fnmax1/MiniArcadePCB/MiniArcade_Documentation/Bilder/Oszi_powersupply.jpg

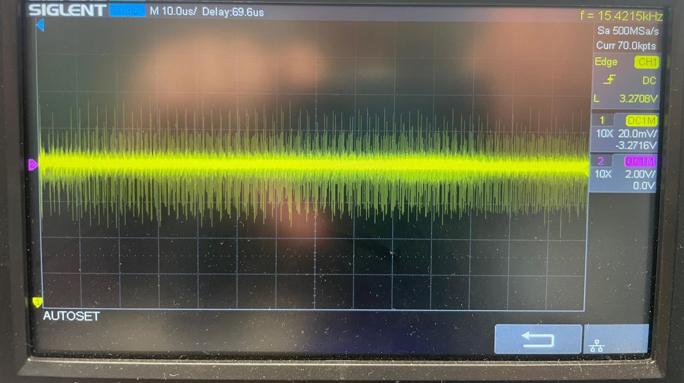
MiniArcade_Documentation/Bilder/Oszi_powersupply.jpg
