fnmax1/MiniArcadePCB/MiniArcade_Documentation/Bilder/Verbindungssystem.png

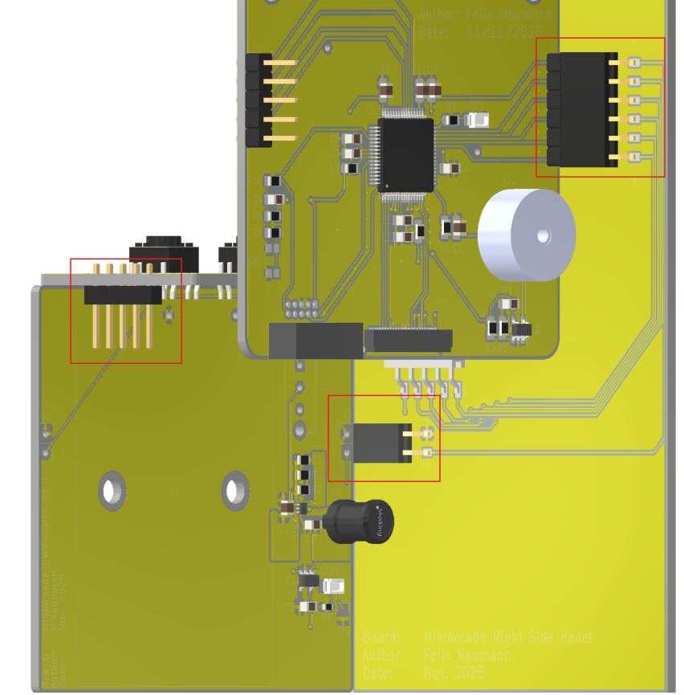
MiniArcade_Documentation/Bilder/Verbindungssystem.png
