fnmax1/MiniArcadePCB/README.md

# MiniArcade
This repository provides a complete kit for a handheld console
in the form of an arcade machine.
