fnmax1/MiniArcadePCB/MiniArcade_Documentation/Bilder/assynchroner Callback.png

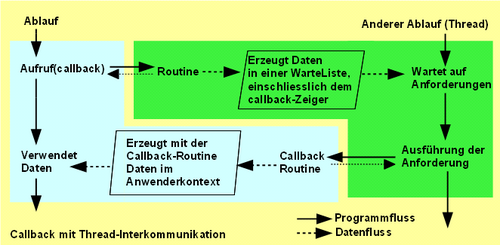
MiniArcade_Documentation/Bilder/assynchroner Callback.png
