fnmax1/MiniArcadePCB/MiniArcade_Documentation/Excel/BOM.xlsx

Funktion | Hersteller Bez. | Kosten in € | Anzahl |  | Website
Main Board
J-Tag Header | 62701021721 | 1.56 | 1 |  | https://www.mouser.de/ProductDetail/Wurth-Elektronik/62701021721?qs=1Kr7Jg1SGW%2FQWdVcBDZJJw%3D%3D
Mikrokonroller | SAMD21J18A-A
User LED | AA3021LZGSK | 0.46 | 1 |  | https://www.mouser.de/ProductDetail/Kingbright/AA3021LZGSK?qs=Oo40KB9lBTmpa6y%2FkjbgOw%3D%3D
Ferrit Bead | 742792022 | 0.2 | 1 |  | https://www.mouser.de/ProductDetail/Wurth-Elektronik/742792022?qs=5twSNpOB8IBksnQcn3fDWA%3D%3D
Piezo Buzzer | CPT-1207-3TH | 0.43 | 1 |  | https://www.mouser.de/ProductDetail/Same-Sky/CPT-1207-3TH?qs=yc9RBI4tIAKnzAUaZUSj3A%3D%3D
OpAmp | LM321LVIDBVR | 0.11 | 1 |  | https://www.mouser.de/ProductDetail/Texas-Instruments/LM321LVIDBVR?qs=qSfuJ%252Bfl%2Fd66sZ569ResAQ%3D%3D
LCD | ER-TFT1.44-1 | 2.42 | 1 | ??? | https://www.buydisplay.com/1-44-inch-tft-touch-screen-serial-spi-128x128-lcd-display-module-st7735
FPC-Connector | F3311A7H121026E200 | 0.34 | 1 |  | https://www.mouser.de/ProductDetail/Amphenol-Aorora/F3311A7H121026E200?qs=DPoM0jnrROWA%252B19vFqAjpg%3D%3D
Power Supply
Buck Converter | AP61100Z6-7 | 0.17 | 1 |  | https://www.mouser.de/ProductDetail/Diodes-Incorporated/AP61100Z6-7
Power LED | AA3021LZGSK | 0.46 | 1 |  | https://www.mouser.de/ProductDetail/Kingbright/AA3021LZGSK?qs=Oo40KB9lBTmpa6y%2FkjbgOw%3D%3D
LDO | MIC94310-SYM5-TR | 0.27 | 1 |  | https://www.mouser.de/ProductDetail/Microchip-Technology/MIC94310-SYM5-TR
Power-Switch | SLW-12689-4A-N-D | 0.29 | 1 |  | https://www.mouser.de/ProductDetail/Same-Sky/SLW-12689-4A-N-D?qs=IKkN%2F947nfDDpe%2FKbSKjtQ%3D%3D
Induktivität 2,2 uH | 7447462022 (https://www.we-online.com/de/components/products/WE-TI) | 0.82 | 1 |  | https://www.mouser.de/ProductDetail/Wurth-Elektronik/7447462022?qs=E%2F%2FhvbtCqpMsMx%2FJLvSyVw%3D%3D
Induktivität 3,3 uH | 7447462033 | 0.82 | 1 |  | https://www.mouser.de/ProductDetail/Wurth-Elektronik/7447462033?qs=E%2F%2FhvbtCqpPfgoKy1f3Gmg%3D%3D
Induktivität 4,7 uH | 7447462047 (https://www.we-online.com/de/components/products/WE-TI) | 0.82 | 1 |  | https://www.mouser.de/ProductDetail/Wurth-Elektronik/7447462047?qs=E%2F%2FhvbtCqpMqhMG1oun6Ug%3D%3D
Batterie Holder | 2479 | 1.26 | 1 |  | https://www.mouser.de/ProductDetail/Keystone-Electronics/2479?qs=Q3RoVmURDomBPD85HfXZoA%3D%3D
Controller
Joystick | 10*10*9-6P WX | 0.37 | 1 |  | https://www.lcsc.com/product-detail/C2858290.html
Left Side Panel
PinHeader_1x2_female_90° | M20-7910242R | 0.61 | 1 |  | https://www.mouser.de/ProductDetail/Harwin/M20-7910242R?qs=k41KVqW3ympOgmj181bijA%3D%3D
PinHeader_1x5_female_90° | M20-7910542R | 0.91 | 1 |  | https://www.mouser.de/ProductDetail/Harwin/M20-7910542R?qs=k41KVqW3ymo1Rw%252BkrmwYbQ%3D%3D
PinHeader_1x6_female_90° | M20-7910642R | 1.09 | 1 |  | https://www.mouser.de/ProductDetail/Harwin/M20-7910642R?qs=k41KVqW3ymovSPRowkWy%2Fg%3D%3D
Right Side Panel
PinHeader_1x2_female_90° | M20-7910242R | 0.61 | 1 |  | https://www.mouser.de/ProductDetail/Harwin/M20-7910242R?qs=k41KVqW3ympOgmj181bijA%3D%3D
PinHeader_1x5_female_90° | M20-7910542R | 0.91 | 2 |  | https://www.mouser.de/ProductDetail/Harwin/M20-7910542R?qs=k41KVqW3ymo1Rw%252BkrmwYbQ%3D%3D
USB-C | USB4125-GF-A | 0.51 | 1 |  | https://www.mouser.de/ProductDetail/GCT/USB4125-GF-A?qs=KUoIvG%2F9IlaIQ4zBJ6gLeA%3D%3D
