fnmax1/MiniArcadePCB/CAD/MiniArcade_Right_Sidepanel.step

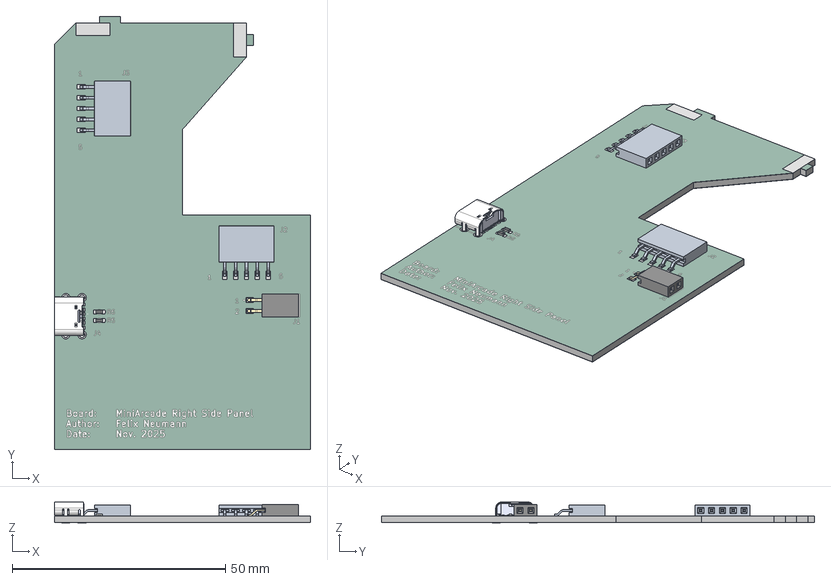
[picture p42: CAD file, 2025-11-26]
CAD/MiniArcade_Right_Sidepanel.step
60.0 x 101.5 x 4.87 mm
R_0603_1608Metric x 2
M20-7910242R
MiniArcade_Right_Sidepanel 1.3.1 x 2
USB4125-GF-A_PART1
MiniArcade_Right_Sidepanel_copper
MiniArcade_Right_Sidepanel_pad
MiniArcade_Right_Sidepanel_silkscreen
MiniArcade_Right_Sidepanel_soldermask x 2
MiniArcade_Right_Sidepanel_PCB
