fnmax1/MiniArcadePCB/CAD/MiniArcade_Left_Sidepanel.step

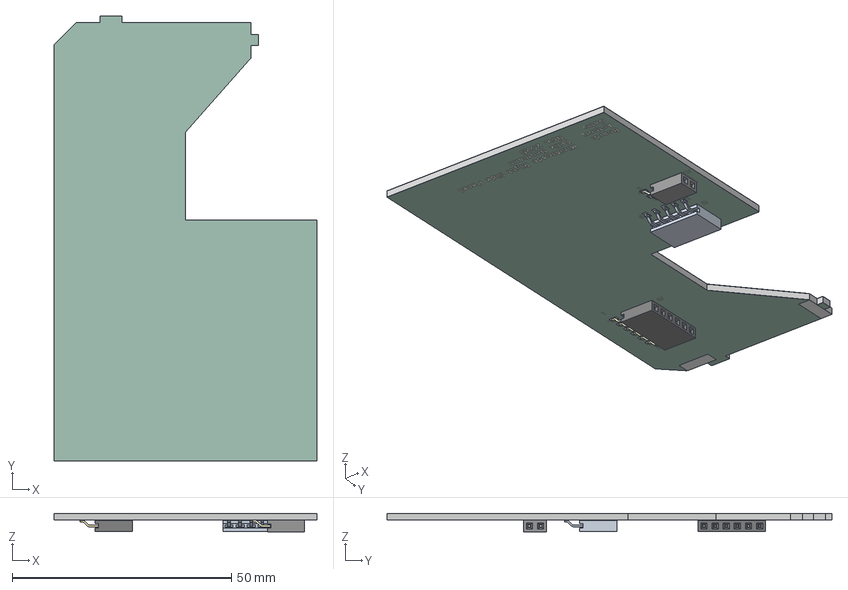
[picture p43: CAD file, 2025-11-26]
CAD/MiniArcade_Left_Sidepanel.step
60.0 x 101.5 x 4.23 mm
MiniArcade_Left_Sidepanel 1.1.1
M20-7910242R
M20-79106_MOULD
M20-79X_CONTACT x 6
MiniArcade_Left_Sidepanel_copper
MiniArcade_Left_Sidepanel_pad
MiniArcade_Left_Sidepanel_via
MiniArcade_Left_Sidepanel_silkscreen
MiniArcade_Left_Sidepanel_soldermask x 2
MiniArcade_Left_Sidepanel_PCB
