fnmax1/MiniArcadePCB/CAD/MiniArcade_Controller.step

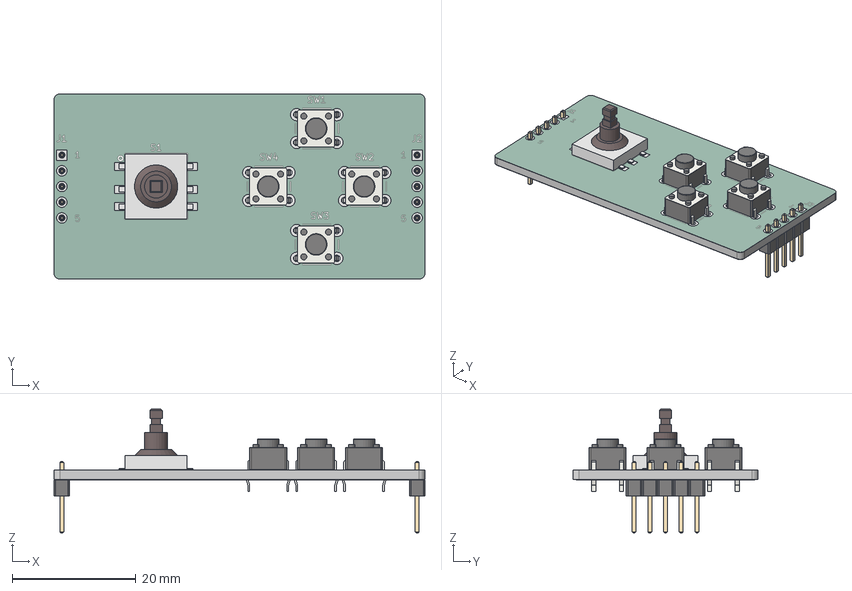
[picture p44: CAD file, 2025-11-26]
CAD/MiniArcade_Controller.step
60.0 x 30.0 x 20.0 mm
SW_PUSH_6mm_H5mm x 4
Joystick
PinHeader_1x05_P2.54mm_Vertical x 2
MiniArcade_Controller_copper
MiniArcade_Controller_pad
MiniArcade_Controller_via
MiniArcade_Controller_silkscreen x 2
MiniArcade_Controller_soldermask x 2
MiniArcade_Controller_PCB
