fnmax1/MiniArcadePCB/CAD/MiniArcade_Back_Cover.step

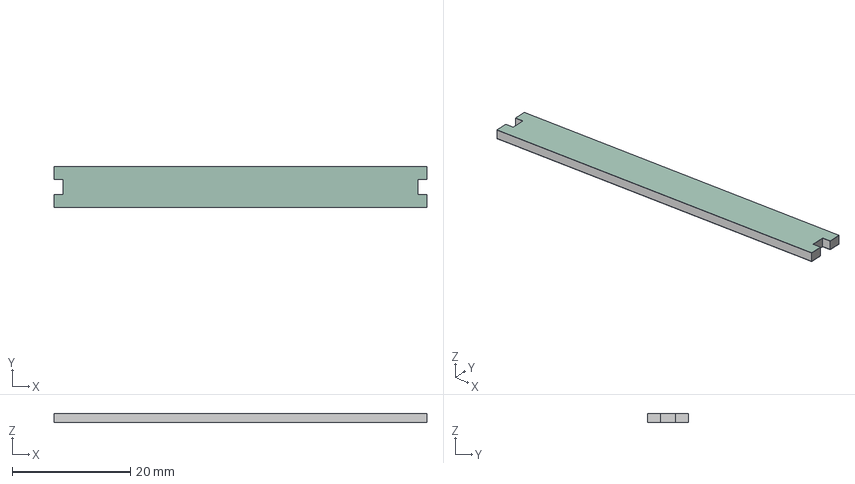
[picture p45: CAD file, 2025-11-25]
CAD/MiniArcade_Back_Cover.step
63.0 x 7.00 x 1.61 mm
MiniArcade_Back_Cover_pad
MiniArcade_Back_Cover_soldermask x 2
MiniArcade_Back_Cover_PCB
