fnmax1/MiniArcadePCB/CAD/MiniArcade_Top_Cover.step

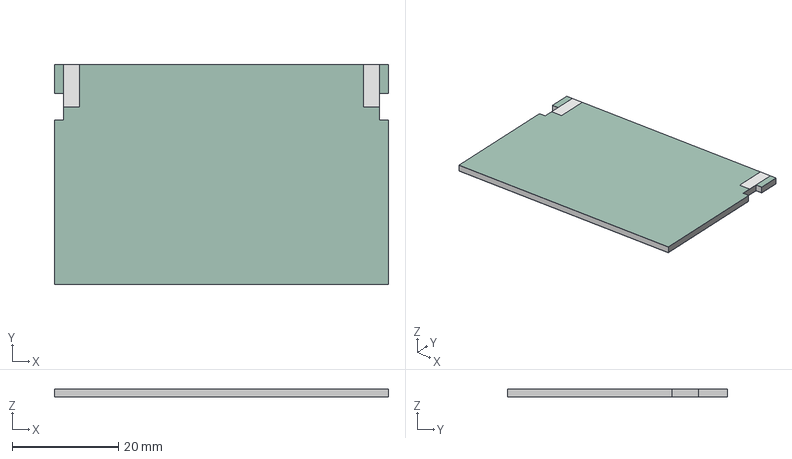
[picture p46: CAD file, 2025-11-25]
CAD/MiniArcade_Top_Cover.step
63.0 x 41.5 x 1.61 mm
MiniArcade_Top_Cover_pad
MiniArcade_Top_Cover_soldermask x 2
MiniArcade_Top_Cover_PCB
