fnmax1/MiniArcadePCB/CAD/MiniArcade_Panel.step

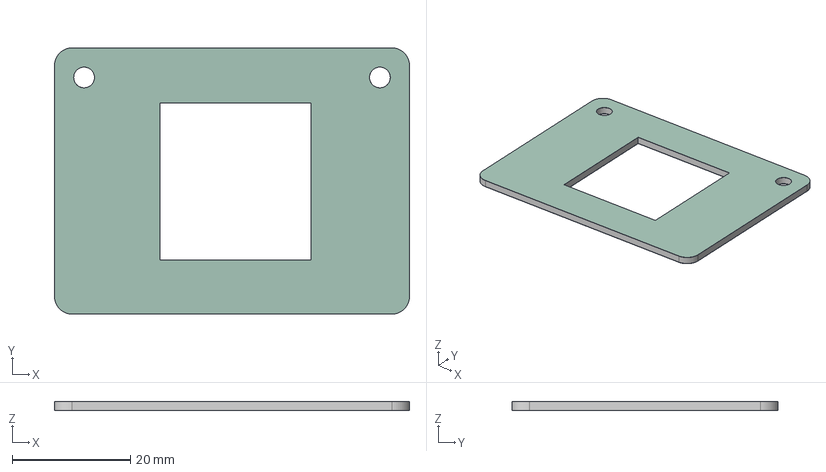
[picture p47: CAD file, 2025-11-21]
CAD/MiniArcade_Panel.step
60.0 x 45.0 x 1.61 mm
MiniArcade_Panel_copper
MiniArcade_Panel_soldermask x 2
MiniArcade_Panel_PCB
