fnmax1/MiniArcadePCB/CAD/MiniArcade_Front_Cover.step

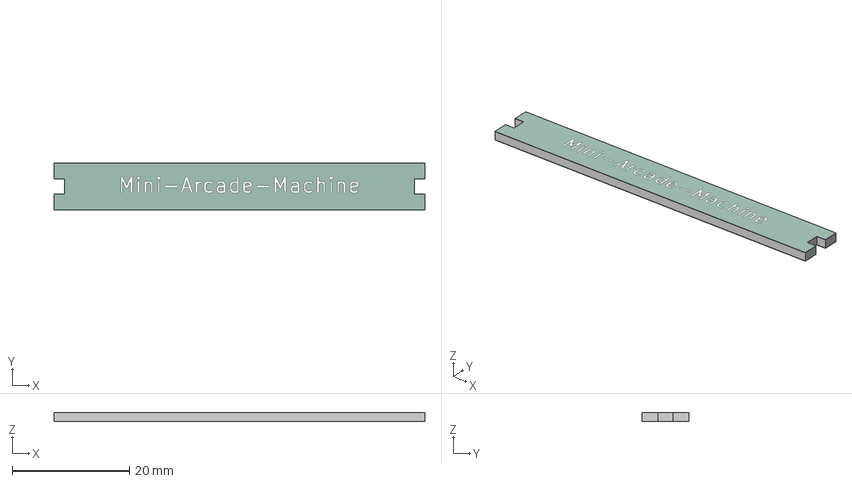
[picture p48: CAD file, 2025-11-21]
CAD/MiniArcade_Front_Cover.step
63.2 x 8.00 x 1.64 mm
MiniArcade_Front_Cover_pad
MiniArcade_Front_Cover_silkscreen
MiniArcade_Front_Cover_soldermask x 2
MiniArcade_Front_Cover_PCB
