fnmax1/MiniArcadePCB/CAD/Spacer_6mm.stp

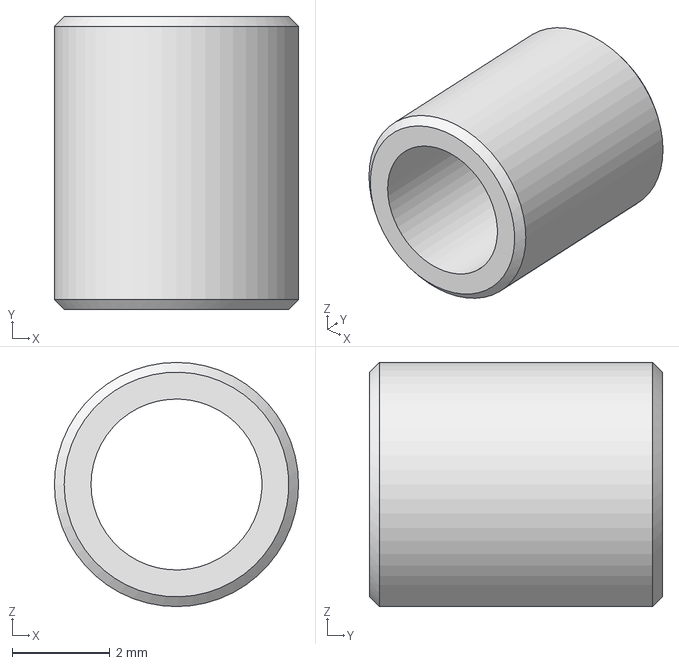
[picture p49: CAD file, 2025-11-21]
CAD/Spacer_6mm.stp
5.00 x 6.00 x 5.00 mm
