fnmax1/MiniArcadePCB/CAD/ERTFT144.stp

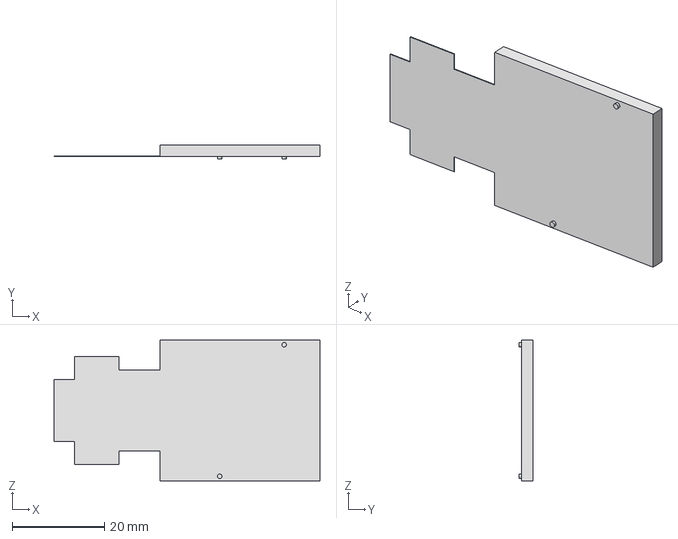
[picture p50: CAD file, 2025-11-19]
CAD/ERTFT144.stp
57.8 x 3.00 x 30.6 mm
