fnmax1/MiniArcadePCB/MiniArcade_PWR_Supply/MiniArcade_PWR_Supply/MiniArcade_PWR_Supply.kicad_pcb

## KiCad design MiniArcade_PWR_Supply/MiniArcade_PWR_Supply/MiniArcade_PWR_Supply.kicad_pcb (2025-12-08)

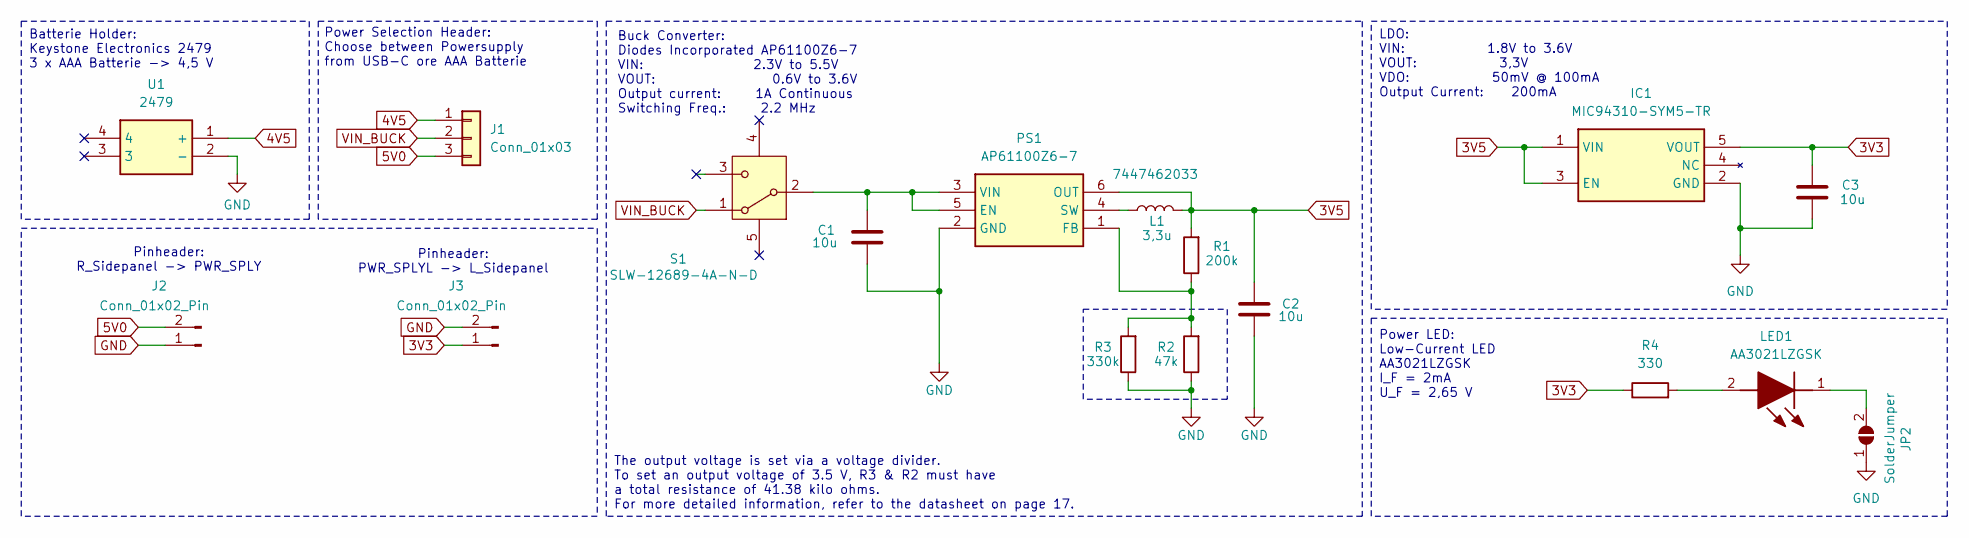
[picture p51: schematic MiniArcade_PWR_Supply.kicad_sch, MiniArcadePowerSupply]

Parts:
C1, C2, C3: 10u; C_0805_2012Metric_Pad1.18x1.45mm_HandSolder
IC1: MIC94310-SYM5-TR; SOT95P280X130-5N; Mouser Part Number 998-MIC94310-SYM5TR
J1: Conn_01x03; PinHeader_1x03_P1.00mm_Vertical
J2, J3: Conn_01x02_Pin; PinHeader_1x02_P2.54mm_Vertical
JP2: SolderJumper; SolderJumper-2_P1.3mm_Open_Pad1.0x1.5mm
L1: 3,3u; WE-TI_507589
LED1: AA3021LZGSK; LEDM3020X150N; Mouser Part Number 604-AA3021LZGSK
PS1: AP61100Z6-7; SOT50P162X60-6N; Mouser Part Number 621-AP61100Z6-7
R1: 200k; R_0805_2012Metric_Pad1.20x1.40mm_HandSolder
R2: 47k; R_0805_2012Metric_Pad1.20x1.40mm_HandSolder
R3: 330k; R_0805_2012Metric_Pad1.20x1.40mm_HandSolder
R4: 330; R_0603_1608Metric_Pad0.98x0.95mm_HandSolder
S1: SLW-12689-4A-N-D; SLW126894AND; Mouser Part Number 179-SLW126894AND
U1: 2479; Mouser Part Number 534-2479

Connections:
3V3: C3.1, IC1.5 (VOUT), J3.1, R4.1
3V5: C2.1, IC1.1 (VIN), IC1.3 (EN), L1.2, PS1.6 (OUT), R1.2
4V5: J1.1, U1.1 (+)
5V0: J1.3, J2.2
GND: C1.2, C2.2, C3.2, IC1.2 (GND), J2.1, J3.2, JP2.1 (A), PS1.2 (GND), R2.1, R3.1, U1.2 (-)
unnamed: JP2.2 (B), LED1.1 (K)
unnamed: LED1.2 (A), R4.2
unnamed: C1.1, PS1.3 (VIN), PS1.5 (EN), S1.2
unnamed: PS1.1 (FB), R1.1, R2.2, R3.2
unnamed: L1.1, PS1.4 (SW)
VIN_BUCK: J1.2, S1.1

Notes on the sheet:
Pinheader: R_Sidepanel -> PWR_SPLY
Batterie Holder: Keystone Electronics 2479 3 x AAA Batterie -> 4,5 V
Power Selection Header: Choose between Powersupply from USB-C ore AAA Batterie
Pinheader: PWR_SPLYL -> L_Sidepanel
The output voltage is set via a voltage divider. To set an output voltage of 3.5 V, R3 & R2 must have a total resistance of 41.38 kilo ohms. For more detailed information, refer to the datasheet on page 17.
Power LED: Low-Current LED AA3021LZGSK I_F = 2mA U_F = 2,65 V
Buck Converter: Diodes Incorporated AP61100Z6-7 VIN: 2.3V to 5.5V VOUT: 0.6V to 3.6V Output current: 1A Continuous Switching Freq.: 2.2 MHz
LDO: VIN: 1.8V to 3.6V VOUT: 3,3V VDO: 50mV @ 100mA Output Current: 200mA

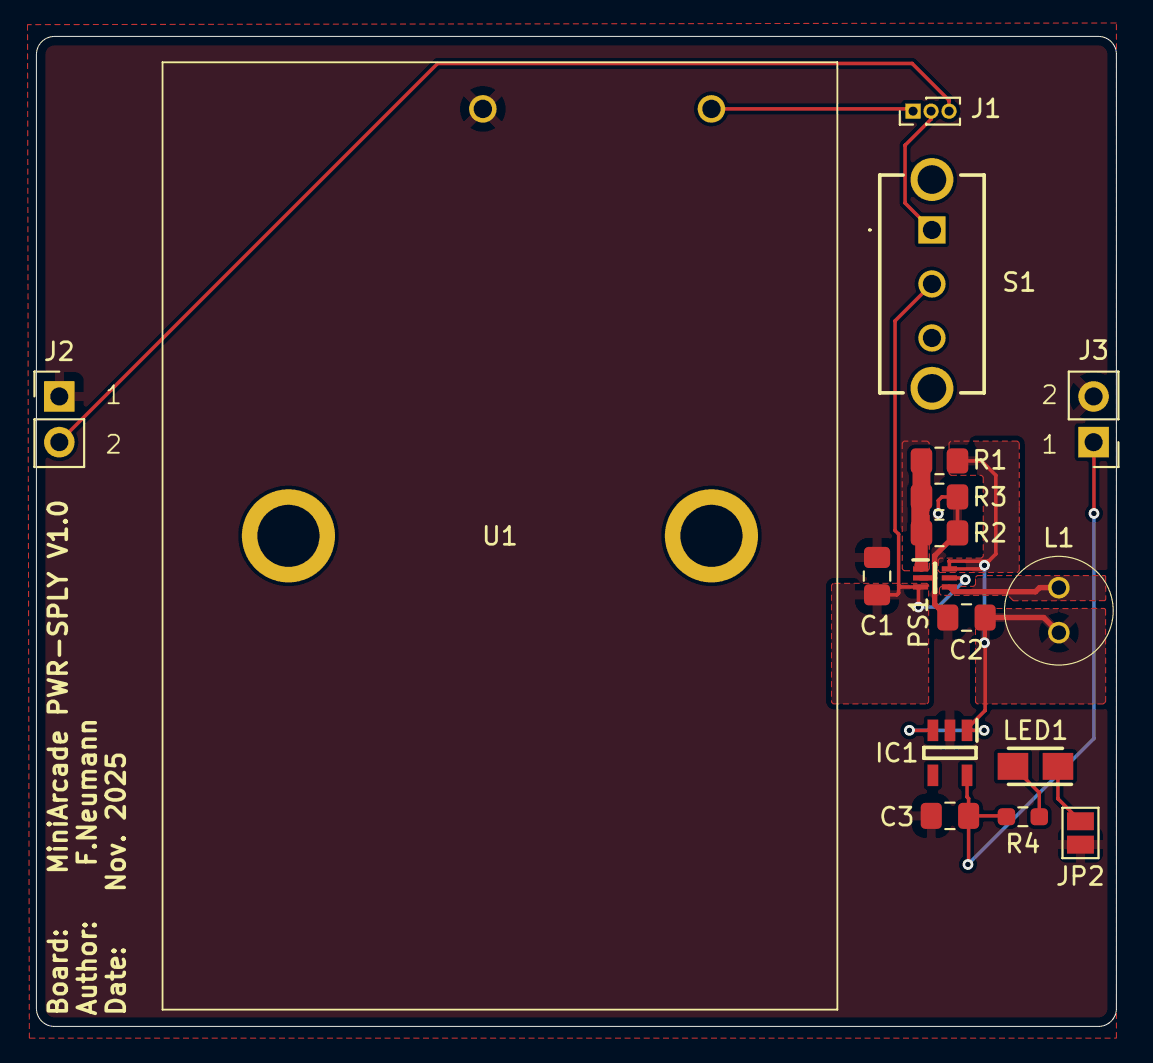
[picture p52: board MiniArcade_PWR_Supply.kicad_pcb from above]

Board: 2 copper layers, 60.0 x 55.0 mm, 17 parts (0 on the bottom side), 11 nets.
