fnmax1/MiniArcadePCB/MiniArcade_Controller/MiniArcade_Controller.kicad_pcb

## KiCad design MiniArcade_Controller/MiniArcade_Controller.kicad_pcb (2025-11-26)

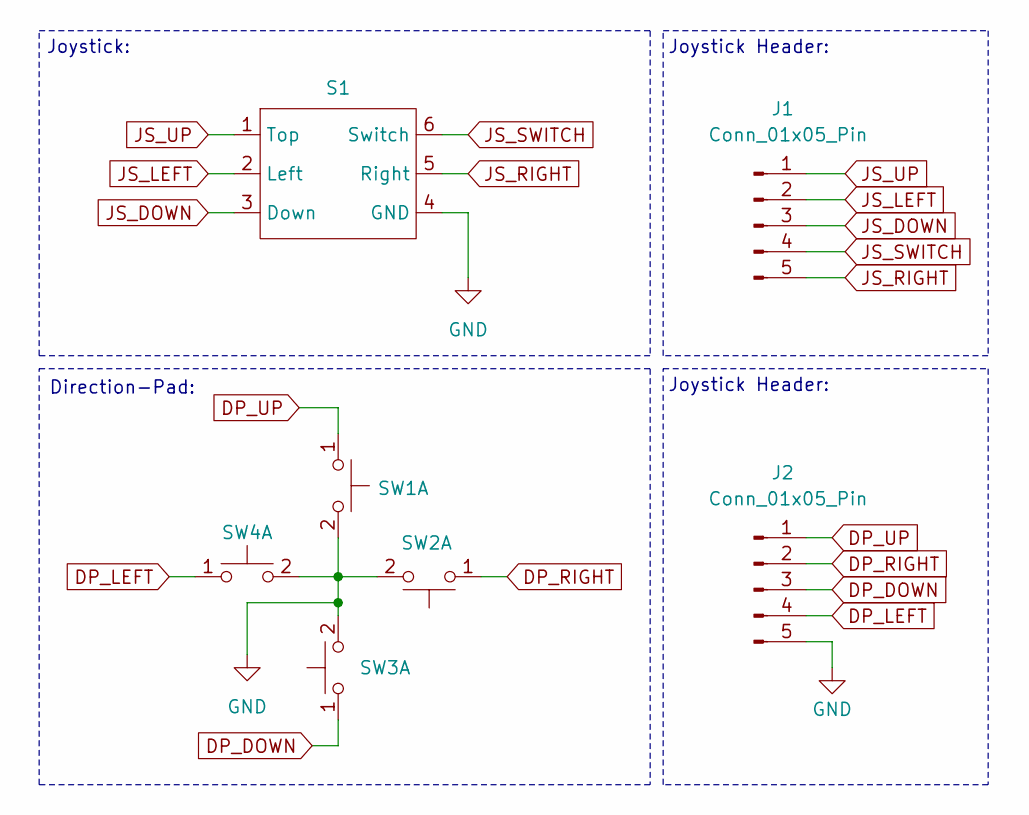
[picture p53: schematic MiniArcade_Controller.kicad_sch, MiniArcadeController]

Parts:
J1, J2: Conn_01x05_Pin; PinHeader_1x05_P2.54mm_Vertical
S1: Joystick
SW1, SW2, SW3, SW4: SW_Push_Dual_x2; SW_PUSH_6mm_H5mm

Connections:
DP_DOWN: J2.3, SW3.1 (C)
DP_LEFT: J2.4, SW4.1 (C)
DP_RIGHT: J2.2, SW2.1 (C)
DP_UP: J2.1, SW1.1 (C)
GND: J2.5, S1.4 (GND), SW1.2 (D), SW2.2 (D), SW3.2 (D), SW4.2 (D)
JS_DOWN: J1.3, S1.3 (Down)
JS_LEFT: J1.2, S1.2 (Left)
JS_RIGHT: J1.5, S1.5 (Right)
JS_SWITCH: J1.4, S1.6 (Switch)
JS_UP: J1.1, S1.1 (Top)

Notes on the sheet:
Joystick Header:
Direction-Pad:
Joystick:

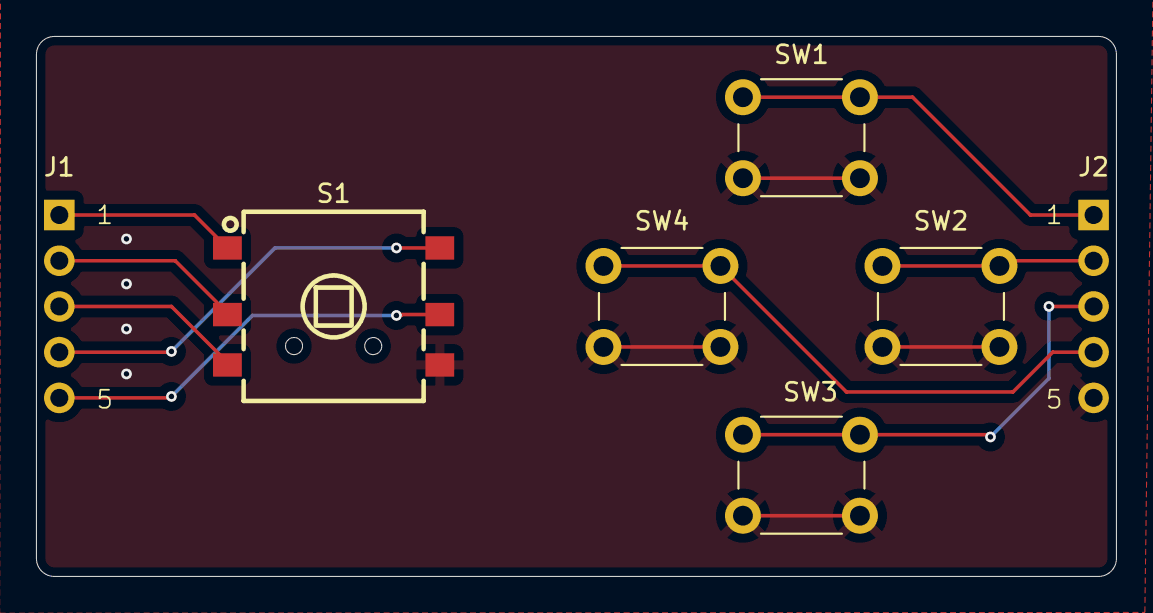
[picture p54: board MiniArcade_Controller.kicad_pcb from above]

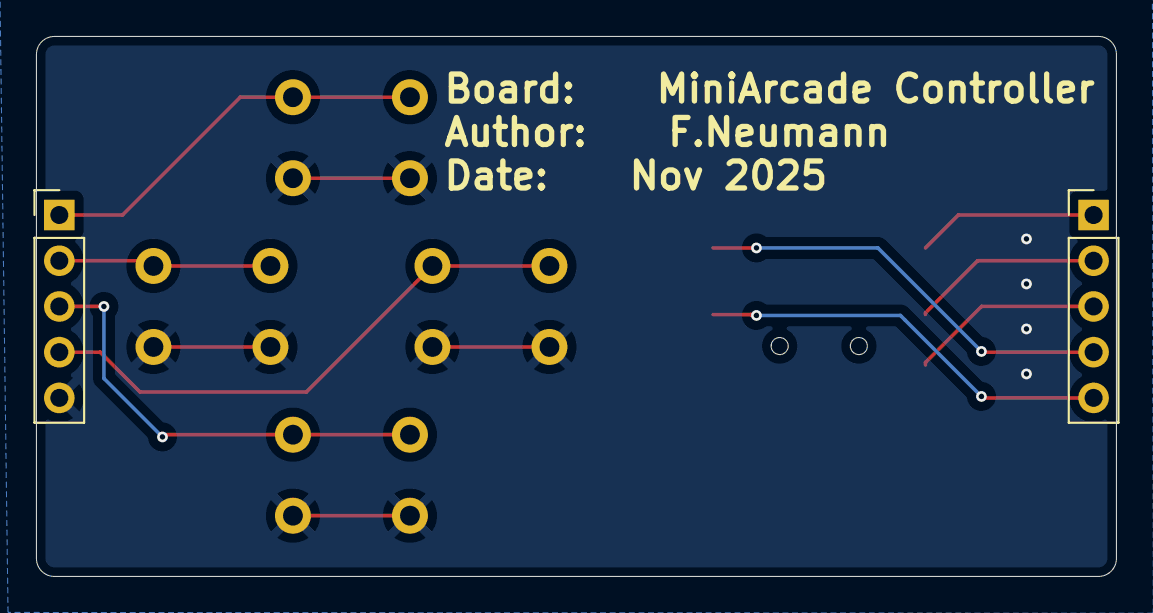
[picture p55: board MiniArcade_Controller.kicad_pcb from below]

Board: 2 copper layers, 60.0 x 30.0 mm, 7 parts (2 on the bottom side), 10 nets.
