fnmax1/MiniArcadePCB/MiniArcade_Right_Sidepanel/MiniArcade_Right_Sidepanel.kicad_pcb

## KiCad design MiniArcade_Right_Sidepanel/MiniArcade_Right_Sidepanel.kicad_pcb (2025-11-26)

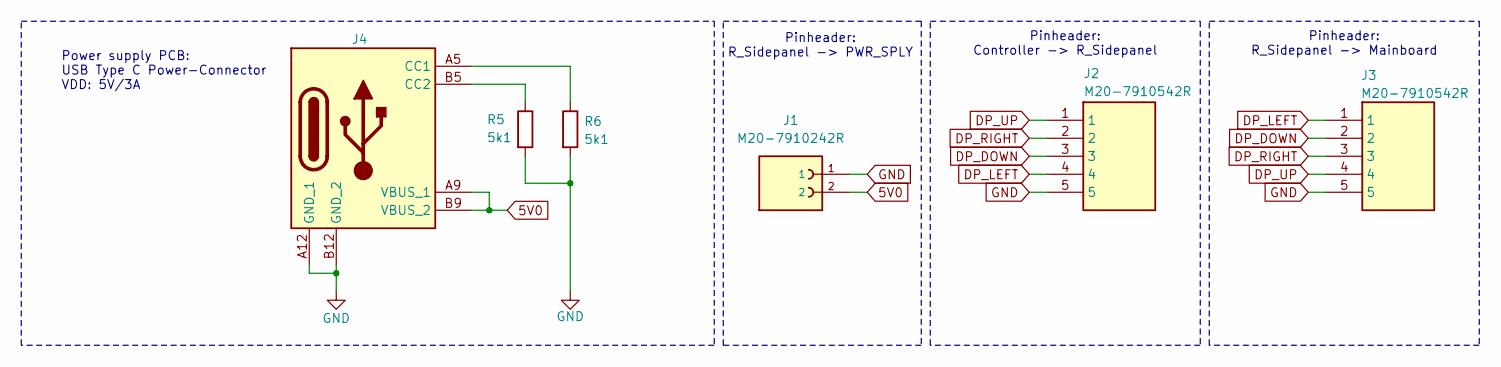
[picture p56: schematic MiniArcade_Right_Sidepanel.kicad_sch]

Parts:
J1: M20-7910242R; HARWIN_M20-7910242R; PARTREV 3
J2, J3: M20-7910542R; M207910542R; Mouser Part Number 855-M20-7910542R
J4: USB4125GFA
R5, R6: 5k1; R_0603_1608Metric_Pad0.98x0.95mm_HandSolder

Connections:
5V0: J1.2, J4.A9 (VBUS_1), J4.B9 (VBUS_2)
DP_DOWN: J2.3, J3.2
DP_LEFT: J2.4, J3.1
DP_RIGHT: J2.2, J3.3
DP_UP: J2.1, J3.4
GND: J1.1, J2.5, J3.5, J4.A12 (GND_1), J4.B12 (GND_2), R5.2, R6.2
unnamed: J4.A5 (CC1), R6.1
unnamed: J4.B5 (CC2), R5.1

Notes on the sheet:
Pinheader: R_Sidepanel -> Mainboard
Power supply PCB: USB Type C Power-Connector VDD: 5V/3A
Pinheader: Controller -> R_Sidepanel
Pinheader: R_Sidepanel -> PWR_SPLY

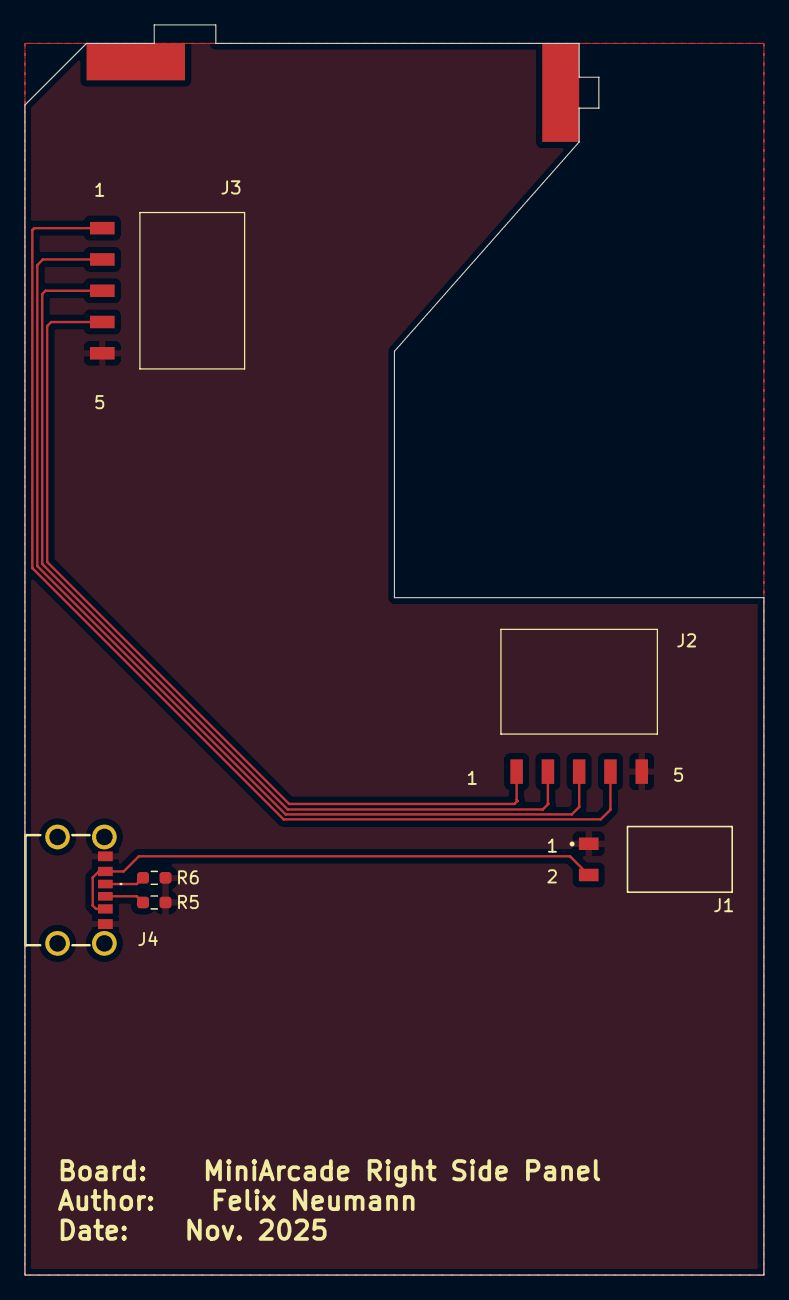
[picture p57: board MiniArcade_Right_Sidepanel.kicad_pcb from above]

Board: 2 copper layers, 60.0 x 101.5 mm, 6 parts (0 on the bottom side), 8 nets.
