fnmax1/MiniArcadePCB/MiniArcade_MainBoard/MiniArcade_MainBoard.kicad_pcb

## KiCad design MiniArcade_MainBoard/MiniArcade_MainBoard.kicad_pcb (2025-11-26)

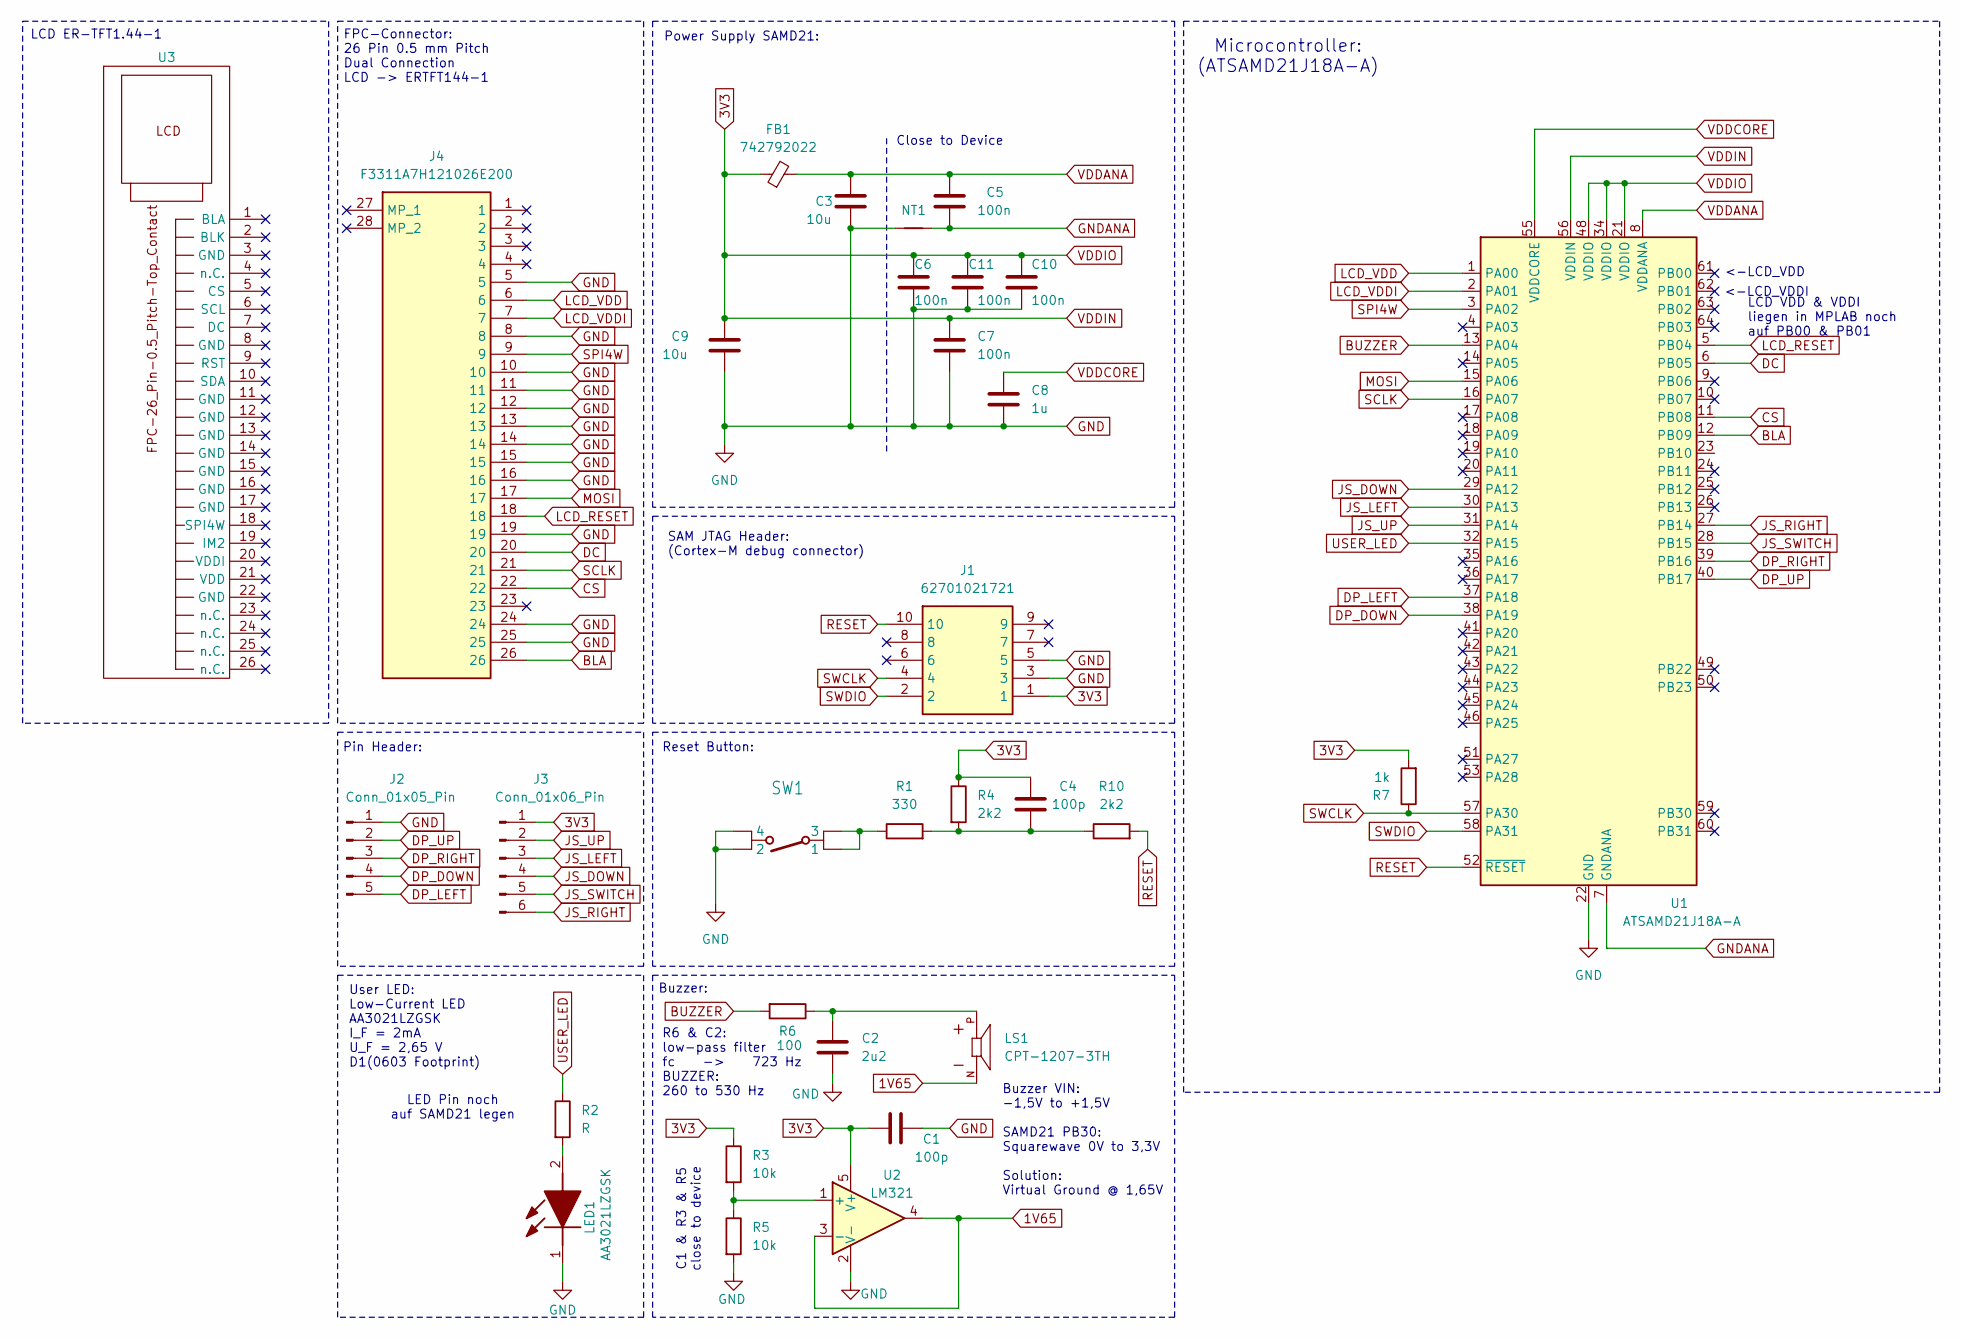
[picture p58: schematic MiniArcade_MainBoard.kicad_sch, MiniArcadeMainboard]

Parts:
C1, C4: 100p; C_0805_2012Metric_Pad1.18x1.45mm_HandSolder
C2: 2u2; C_0805_2012Metric_Pad1.18x1.45mm_HandSolder
C3, C9: 10u; C_0805_2012Metric_Pad1.18x1.45mm_HandSolder
C5, C6, C7, C10, C11: 100n; C_0805_2012Metric_Pad1.18x1.45mm_HandSolder
C8: 1u; C_0805_2012Metric_Pad1.18x1.45mm_HandSolder
FB1: 742792022; R_0805_2012Metric_Pad1.20x1.40mm_HandSolder; Mouser Part Number 710-742792022
J1: 62701021721; Manufacturer_Part_Number 62701021721
J2: Conn_01x05_Pin; PinHeader_1x05_P2.54mm_Vertical
J3: Conn_01x06_Pin; PinHeader_1x06_P2.54mm_Vertical
J4: F3311A7H121026E200; Mouser Part Number 649-311A7H121026E200
LED1: AA3021LZGSK; LEDM3020X150N; Mouser Part Number 604-AA3021LZGSK
LS1: CPT-1207-3TH; SPKR_CPT-1207-3TH; PARTREV 1.0
NT1: NetTie_2; NetTie-2_SMD_Pad0.5mm
R1: 330; R_0805_2012Metric_Pad1.20x1.40mm_HandSolder
R2: R; R_0805_2012Metric_Pad1.20x1.40mm_HandSolder
R3, R5: 10k; R_0805_2012Metric_Pad1.20x1.40mm_HandSolder
R4, R10: 2k2; R_0805_2012Metric_Pad1.20x1.40mm_HandSolder
R6: 100; R_0805_2012Metric_Pad1.20x1.40mm_HandSolder
R7: 1k; R_0805_2012Metric_Pad1.20x1.40mm_HandSolder
SW1: EVPAA
U1: ATSAMD21J18A-A; TQFP-64_10x10mm_P0.5mm
U2: LM321; SOT95P280X145-5N
U3: ERTFT144

Connections:
1V65: LS1.N, U2.3 (-), U2.4
3V3: C1.1, C4.1, C6.1, C7.1, C9.1, C10.1, C11.1, FB1.1, J1.1, J3.1, R3.1, R4.1, R7.2, U1.21 (VDDIO), U1.34 (VDDIO), U1.48 (VDDIO), U1.56 (VDDIN), U2.5 (V+)
BLA: J4.26, U1.12 (PB09)
BUZZER: R6.2, U1.13 (PA04)
CS: J4.22, U1.11 (PB08)
DC: J4.20, U1.6 (PB05)
DP_DOWN: J2.4, U1.38 (PA19)
DP_LEFT: J2.5, U1.37 (PA18)
DP_RIGHT: J2.3, U1.39 (PB16)
DP_UP: J2.2, U1.40 (PB17)
GND: C1.2, C2.1, C3.2, C6.2, C7.2, C8.2, C9.2, C10.2, C11.2, J1.3, J1.5, J2.1, J4.5, J4.8, J4.10, J4.11, J4.12, J4.13, J4.14, J4.15, J4.16, J4.19, J4.24, J4.25, LED1.1 (K), NT1.1, R5.2, SW1.2, SW1.4, U1.22 (GND), U1.33 (GND), U1.47 (GND), U1.54 (GND), U2.2 (V-)
GNDANA: C5.2, NT1.2, U1.7 (GNDANA)
JS_DOWN: J3.4, U1.29 (PA12)
JS_LEFT: J3.3, U1.30 (PA13)
JS_RIGHT: J3.6, U1.27 (PB14)
JS_SWITCH: J3.5, U1.28 (PB15)
JS_UP: J3.2, U1.31 (PA14)
LCD_RESET: J4.18, U1.5 (PB04)
LCD_VDD: J4.6, U1.1 (PA00)
LCD_VDDI: J4.7, U1.2 (PA01)
MOSI: J4.17, U1.15 (PA06)
unnamed: C2.2, LS1.P, R6.1
unnamed: C4.2, R1.2, R4.2, R10.1
unnamed: LED1.2 (A), R2.2
unnamed: R1.1, SW1.1, SW1.3
unnamed: R3.2, R5.1, U2.1 (+)
RESET: J1.10, R10.2, U1.52 (~RESET)
SCLK: J4.21, U1.16 (PA07)
SPI4W: J4.9, U1.3 (PA02)
SWCLK: J1.4, R7.1, U1.57 (PA30)
SWDIO: J1.2, U1.58 (PA31)
USER_LED: R2.1, U1.32 (PA15)
VDDANA: C3.1, C5.1, FB1.2, U1.8 (VDDANA)
VDDCORE: C8.1, U1.55 (VDDCORE)

Notes on the sheet:
Power Supply SAMD21:
LCD VDD & VDDI liegen in MPLAB noch auf PB00 & PB01
SAM JTAG Header: (Cortex-M debug connector)
Buzzer:
User LED: Low-Current LED AA3021LZGSK I_F = 2mA U_F = 2,65 V D1(0603 Footprint)
LCD ER-TFT1.44-1
LED Pin noch auf SAMD21 legen
Reset Button:
<-LCD_VDD
Microcontroller: (ATSAMD21J18A-A)
Pin Header:
R6 & C2: low-pass filter fc -> 723 Hz BUZZER: 260 to 530 Hz
FPC-Connector: 26 Pin 0.5 mm Pitch Dual Connection LCD -> ERTFT144-1
Close to Device
Buzzer VIN: -1,5V to +1,5V SAMD21 PB30: Squarewave 0V to 3,3V Solution: Virtual Ground @ 1,65V
<-LCD_VDDI
C1 & R3 & R5 close to device

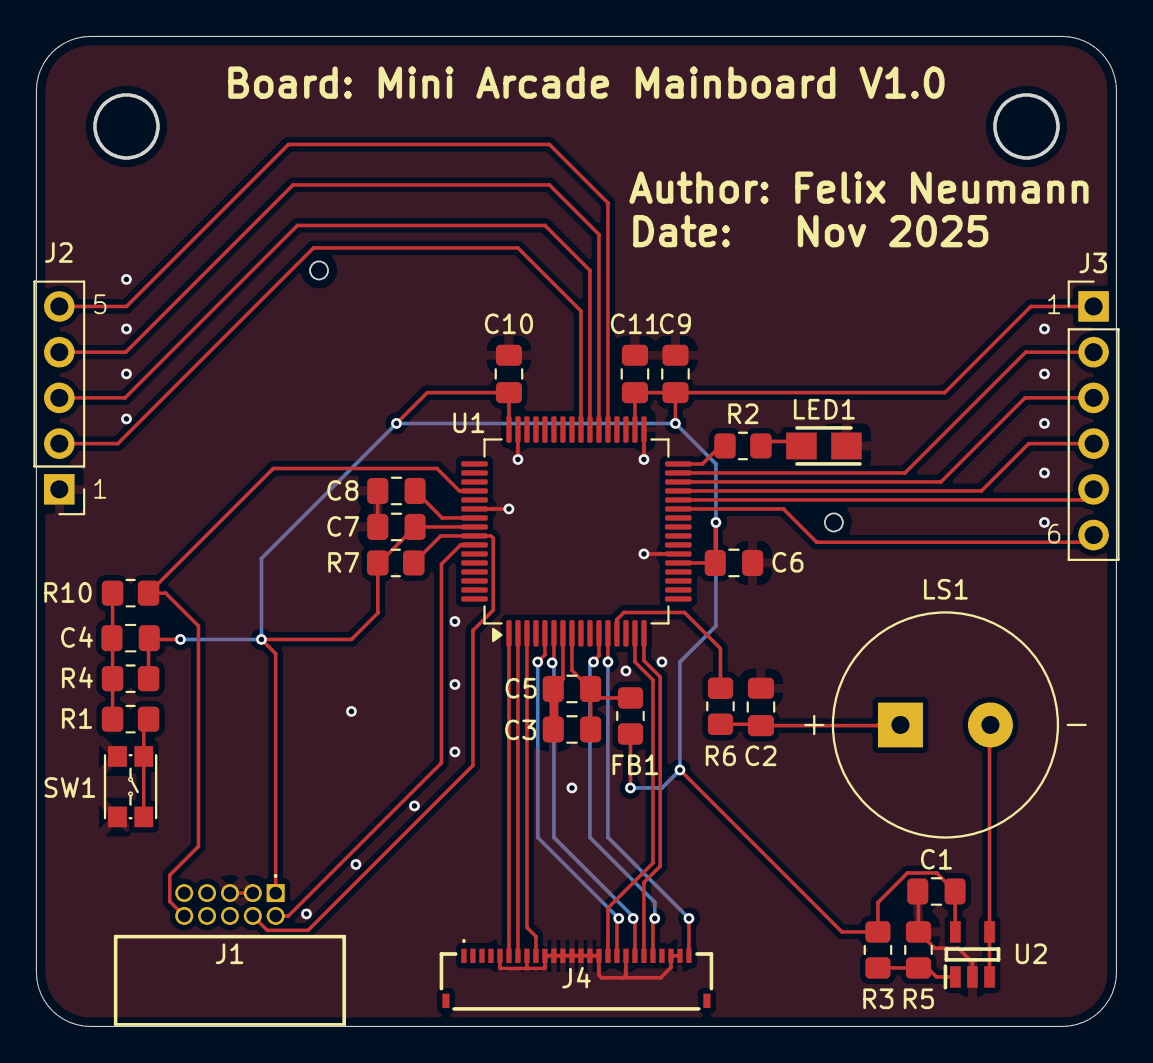
[picture p59: board MiniArcade_MainBoard.kicad_pcb from above]

Board: 2 copper layers, 60.0 x 55.0 mm, 31 parts (1 on the bottom side), 34 nets.
