fnmax1/MiniArcadePCB/MiniArcade_Left_Sidepanel/MiniArcade_Left_Sidepanel.kicad_pcb

## KiCad design MiniArcade_Left_Sidepanel/MiniArcade_Left_Sidepanel.kicad_pcb (2025-11-26)

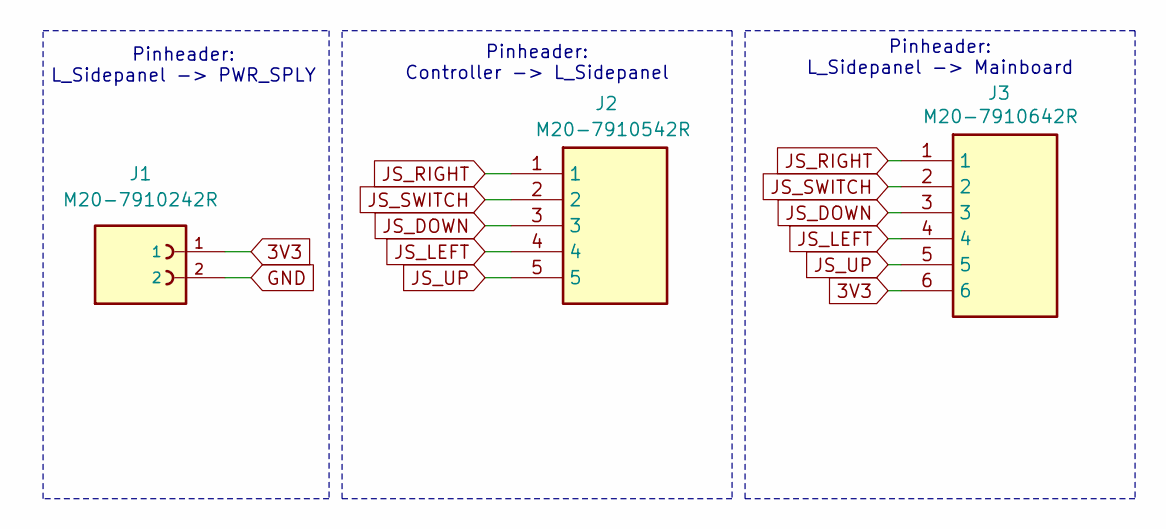
[picture p60: schematic MiniArcade_Left_Sidepanel.kicad_sch]

Parts:
J1: M20-7910242R; HARWIN_M20-7910242R; PARTREV 3
J2: M20-7910542R; M207910542R; Mouser Part Number 855-M20-7910542R
J3: M20-7910642R; M207910642R; Mouser Part Number 855-M20-7910642R

Connections:
3V3: J1.1, J3.6
GND: J1.2
JS_DOWN: J2.3, J3.3
JS_LEFT: J2.4, J3.4
JS_RIGHT: J2.1, J3.1
JS_SWITCH: J2.2, J3.2
JS_UP: J2.5, J3.5

Notes on the sheet:
Pinheader: Controller -> L_Sidepanel
Pinheader: L_Sidepanel -> PWR_SPLY
Pinheader: L_Sidepanel -> Mainboard

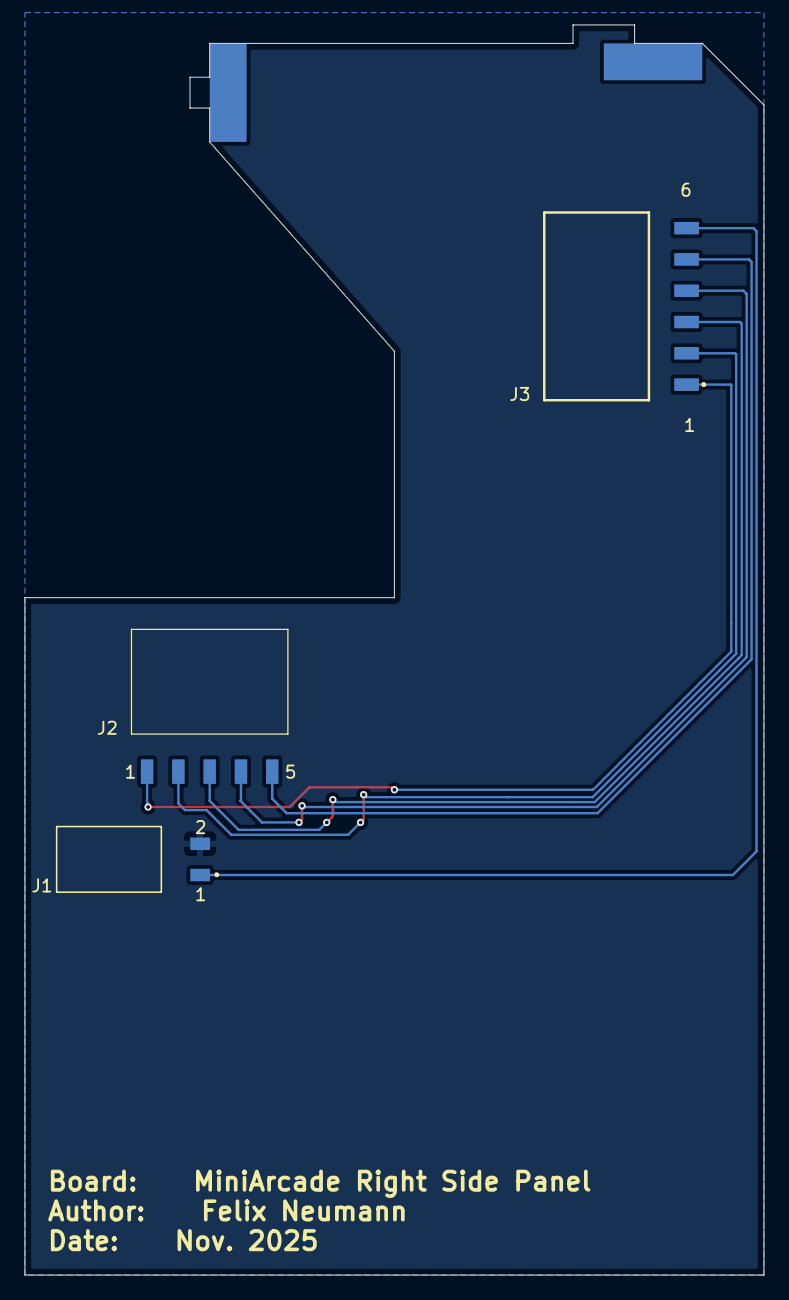
[picture p61: board MiniArcade_Left_Sidepanel.kicad_pcb from below]

Board: 2 copper layers, 60.0 x 101.5 mm, 3 parts (3 on the bottom side), 6 nets.
