fnmax1/MiniArcadePCB/(commit log)

2025-10-28 MiniArcadeController Initial Commit
    [MiniArcade_Controller.kicad_pcb, MiniArcade_Controller.kicad_sch]
2025-10-28 MiniArcadePowerSupply Initial Commit
    [MiniArcade_PWR_Supply.kicad_pcb, MiniArcade_PWR_Supply.kicad_sch]
2025-10-28 MiniArcade Mainboard Initial Commit
    [MiniArcade_MainBoard.kicad_pcb, MiniArcade_MainBoard.kicad_sch]
2025-10-29 added author and title to shemaitc
    [MiniArcade_Controller.kicad_sch]
2025-10-29 MiniArcade MainBoard & Power Supply initial commit
    [MiniArcade_MainBoard.csv, MiniArcade_MainBoard.kicad_pcb, MiniArcade_MainBoard.kicad_sch, MiniArcade_PWR_Supply.kicad_pcb, MiniArcade_PWR_Supply.kicad_sch]
2025-10-29 title and Author added
    [MiniArcade_MainBoard.kicad_sch, MiniArcade_PWR_Supply.kicad_sch]
2025-11-03 stand 03 11
    [BOM.xlsx, MiniArcade_Left_Sidepanel.kicad_pcb, MiniArcade_Left_Sidepanel.kicad_sch, MiniArcade_MainBoard.kicad_pcb, MiniArcade_MainBoard.kicad_sch, MiniArcade_PWR_Supply.kicad_pcb, MiniArcade_PWR_Supply.kicad_sch, Pin_Out_MiniArcade.xlsx]
2025-11-04 stand 04 11 2025
    [MiniArcade_MainBoard.kicad_pcb, MiniArcade_MainBoard.kicad_sch, Pin_Out_MiniArcade.xlsx]
2025-11-05 05 11 2025
    [BOM.xlsx, MiniArcade_Controller.kicad_pcb, MiniArcade_Controller.kicad_sch, MiniArcade_MainBoard.kicad_sch, MiniArcade_PWR_Supply.kicad_pcb, Pin_Out_MiniArcade.xlsx]
2025-11-10 10 11 2025
    [BOM.xlsx, MiniArcade_PWR_Supply.kicad_pcb, MiniArcade_PWR_Supply.kicad_sch]
2025-11-11 11 11 2025
    [BOM.xlsx, MiniArcade_Left_Sidepanel.kicad_sch, MiniArcade_MainBoard.kicad_pcb, MiniArcade_MainBoard.kicad_sch, MiniArcade_PWR_Supply.kicad_pcb, MiniArcade_PWR_Supply.kicad_sch]
2025-11-12 12 11 2025
    [MiniArcade_Controller.kicad_pcb, MiniArcade_Controller.kicad_sch, MiniArcade_MainBoard.kicad_pcb]
2025-11-14 14 11 2025
    [BOM.xlsx, MiniArcade_Controller.kicad_pcb, MiniArcade_Controller.step, MiniArcade_Left_Sidepanel.kicad_sch, MiniArcade_MainBoard.kicad_pcb, MiniArcade_PWR_Supply.kicad_pcb]
2025-11-17 17 11 2025
    [BOM.xlsx, MiniArcade_Left_Sidepanel.kicad_pcb, MiniArcade_Left_Sidepanel.kicad_sch, MiniArcade_MainBoard.kicad_pcb, MiniArcade_MainBoard.kicad_sch, MiniArcade_PWR_Supply.kicad_pcb, MiniArcade_PWR_Supply.kicad_sch]
2025-11-19 19 11 2025
    [ERTFT144.stp, MiniArcade_Controller.kicad_pcb, MiniArcade_Controller.step, MiniArcade_Left_Sidepanel.kicad_pcb, MiniArcade_Left_Sidepanel.kicad_sch, MiniArcade_Left_Sidepanel.step, MiniArcade_MainBoard.kicad_pcb, MiniArcade_PWR_Supply.kicad_pcb]
2025-11-21 21 11 2025
    [MiniArcade_Front_Cover.kicad_pcb, MiniArcade_Front_Cover.kicad_sch, MiniArcade_Front_Cover.step, MiniArcade_Left_Sidepanel.kicad_pcb, MiniArcade_Left_Sidepanel.step, MiniArcade_Panel.kicad_pcb, MiniArcade_Panel.kicad_sch, MiniArcade_Panel.step]
2025-11-25 25 11 2025
    [MiniArcade_Back_Cover.step, MiniArcade_Controller.kicad_pcb, MiniArcade_Controller.step, MiniArcade_Left_Sidepanel.kicad_pcb, MiniArcade_Left_Sidepanel.step, MiniArcade_Right_Sidepanel.kicad_pcb, MiniArcade_Right_Sidepanel.step, MiniArcade_Top_Cover.kicad_pcb]
2025-11-26 26 11 2025
    [BOM.xlsx, MiniArcade_Controller.kicad_pcb, MiniArcade_Controller.step, MiniArcade_Left_Sidepanel.kicad_pcb, MiniArcade_Left_Sidepanel.step, MiniArcade_MainBoard.kicad_pcb, MiniArcade_MainBoard.kicad_sch, MiniArcade_PWR_Supply.kicad_pcb]
2025-12-08 08 12 2025
    [MiniArcade_PWR_Supply.kicad_pcb]
2026-01-13 13 01 2026
    [BOM.xlsx]
2026-02-06 06 02 2026
    [BOM.xlsx]
